Juitasarii/ForceFootBFC/Electrical/Schematic_Loadcell-STM32-MX.pdf

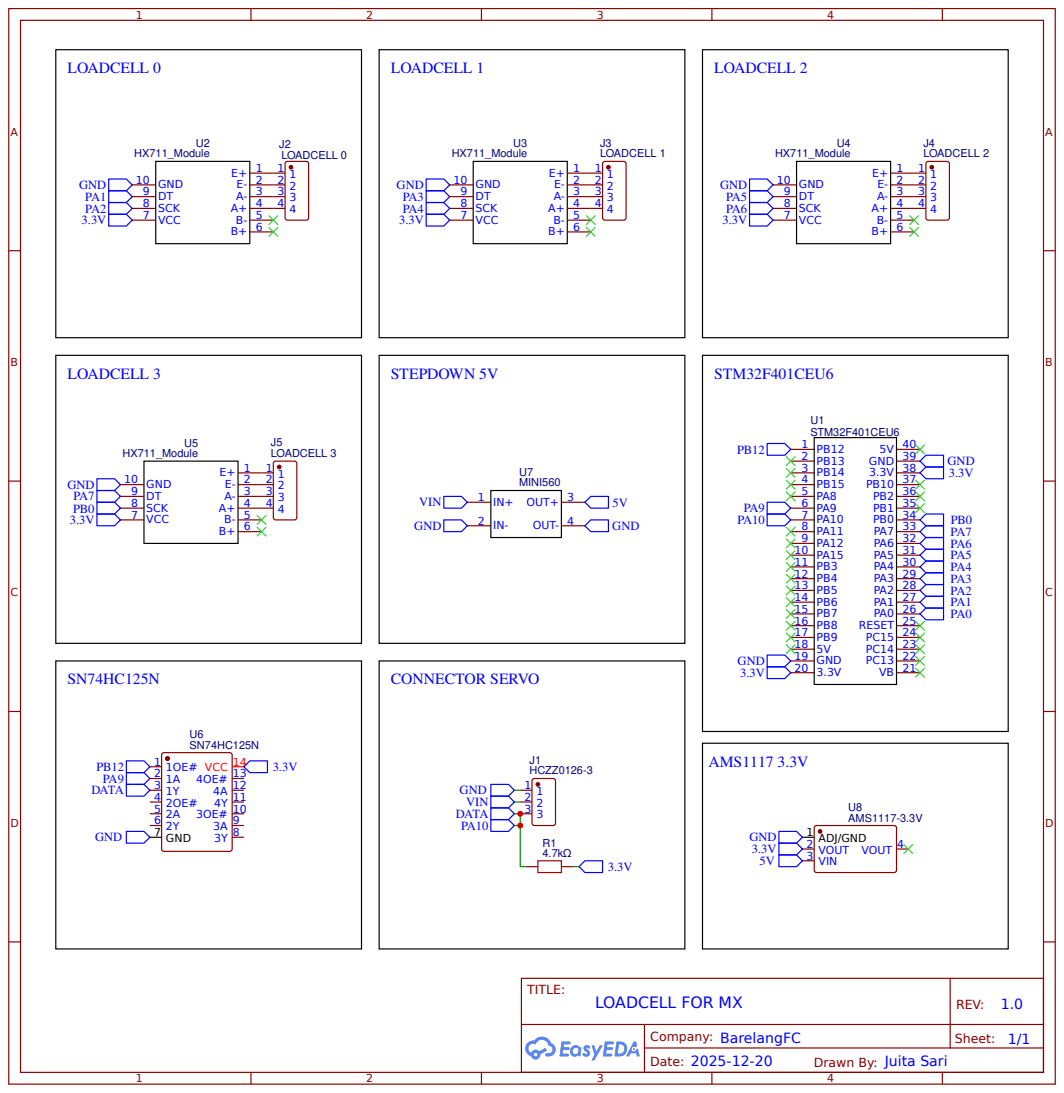
[picture p1: page 1]

B+ 6 VCC 7 SCK 8 DT 9 GND 10

Drawn By: Juita Sari
