Juitasarii/ForceFootBFC/Program/Slave/Loadcell TTL/Core/Inc/main.h

#define DXL_DIR_Pin GPIO_PIN_12
#define DXL_DIR_GPIO_Port GPIOB
#define HC125N_OE_Pin       GPIO_PIN_12
#define HC125N_OE_GPIO_Port GPIOB
