Juitasarii/ForceFootBFC/(commit log)

2026-05-29 Schematic Design
2026-09-14 Remove current status section from README
    Removed current status section from README.
